classnotfound/home-mon/pcb/home_checker/hom_mon_pcb.pdf

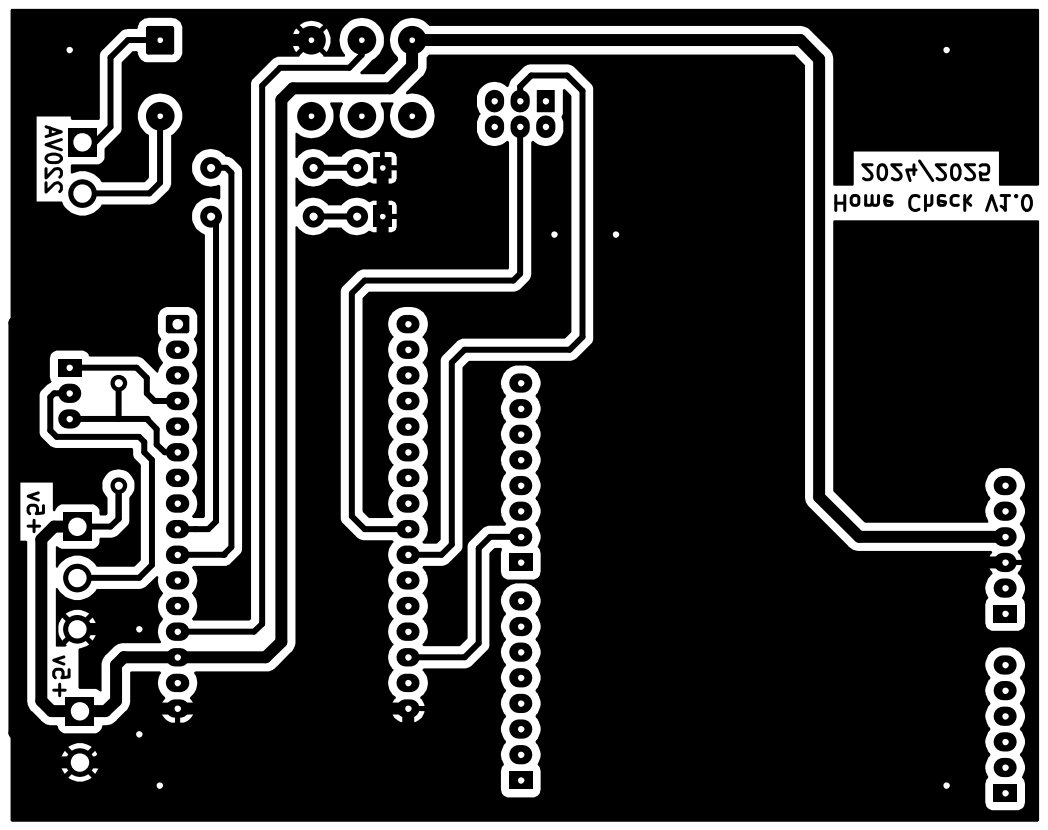
[picture p1: page 1]
