classnotfound/home-mon/pcb/home_checker/home_mon.kicad_pcb

## KiCad design pcb/home_checker/home_mon.kicad_pcb (2025-03-09)

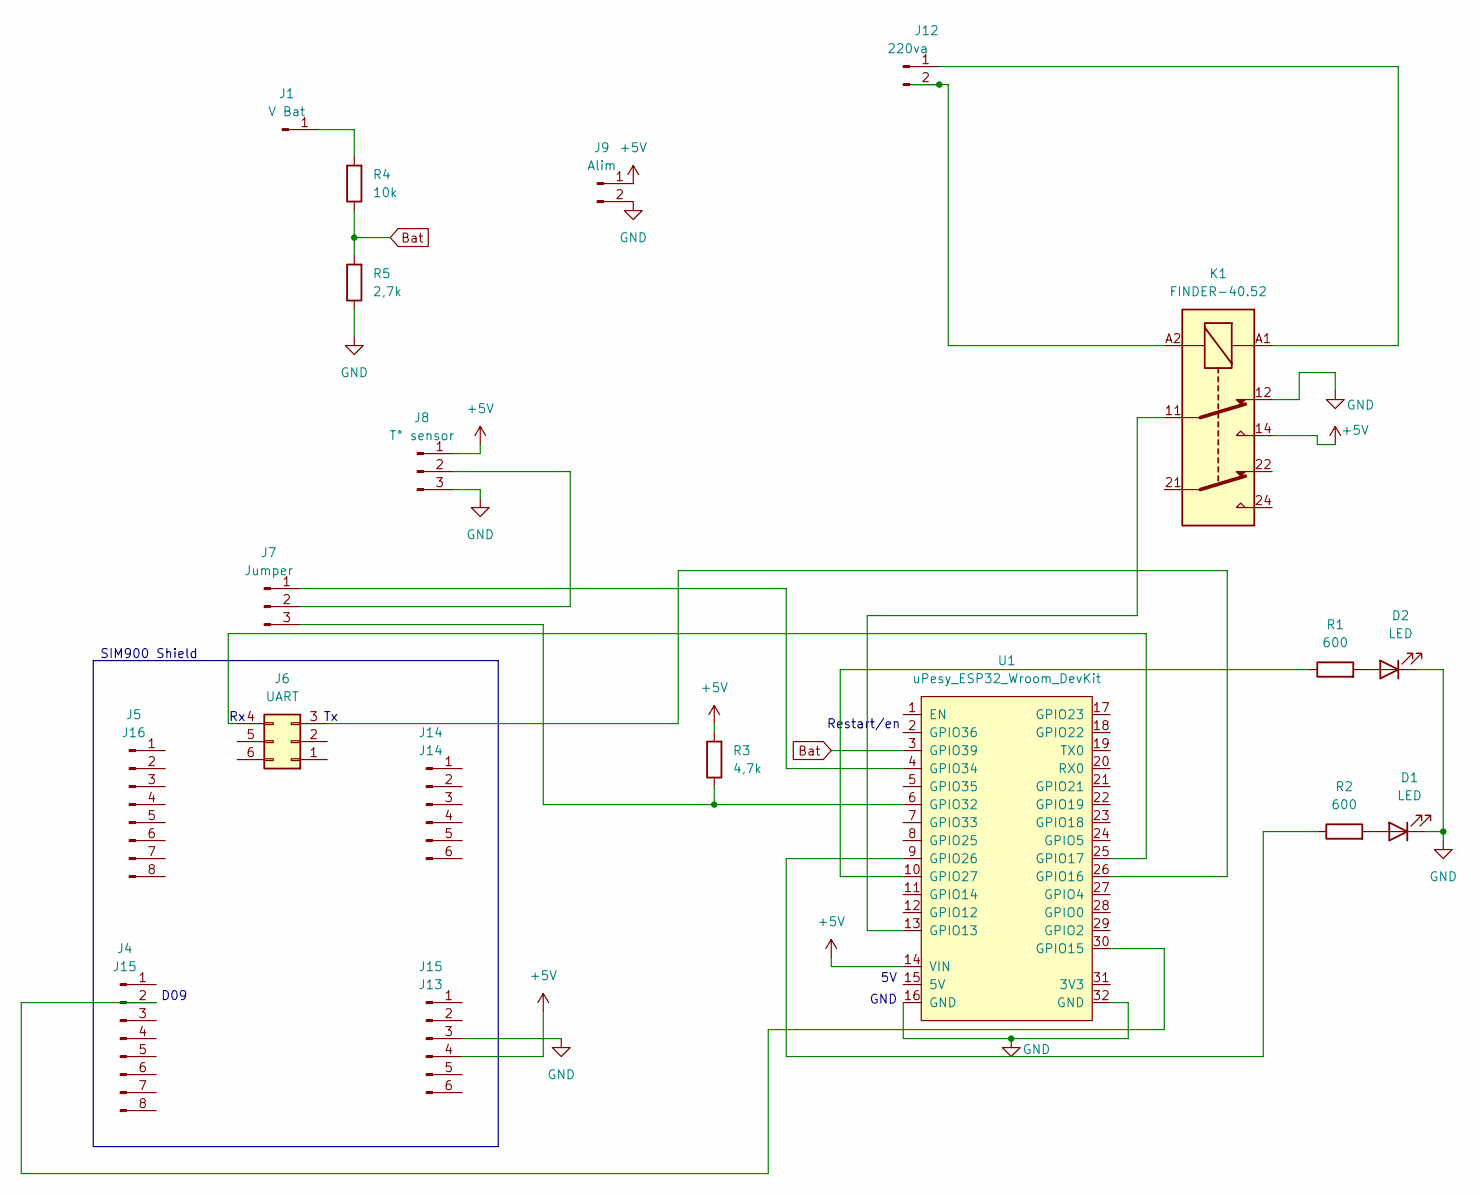
[picture p2: schematic home_mon.kicad_sch]

Parts:
D1, D2: LED; LED_D3.0mm
J1: V Bat; TestPoint_Loop_D1.80mm_Drill1.0mm_Beaded
J4: J15; PinHeader_1x08_P2.54mm_Vertical
J5: J16; PinHeader_1x08_P2.54mm_Vertical
J6: UART; PinHeader_2x03_P2.54mm_Vertical
J7: Jumper; PinHeader_1x03_P2.54mm_Vertical
J8: T° sensor; Samtec_HPM-03-01-x-S_Straight_1x03_Pitch5.08mm
J9: Alim; Samtec_HPM-02-01-x-S_Straight_1x02_Pitch5.08mm
J12: 220va; Samtec_HPM-02-01-x-S_Straight_1x02_Pitch5.08mm
J14: J14; PinHeader_1x06_P2.54mm_Vertical
J15: J13; PinHeader_1x06_P2.54mm_Vertical
K1: FINDER-40.52; Relay_DPDT_Finder_40.52
R1, R2: 600; R_Axial_DIN0207_L6.3mm_D2.5mm_P10.16mm_Horizontal
R3: 4,7k; R_Axial_DIN0207_L6.3mm_D2.5mm_P10.16mm_Horizontal
R4: 10k; R_Axial_DIN0207_L6.3mm_D2.5mm_P10.16mm_Horizontal
R5: 2,7k; R_Axial_DIN0207_L6.3mm_D2.5mm_P10.16mm_Horizontal
U1: uPesy_ESP32_Wroom_DevKit

Connections:
+5V: J8.1, J9.1, J15.4, K1.14, R3.2, U1.14 (VIN)
Bat: R4.1, R5.2, U1.3 (GPIO39)
GND: D1.1 (K), D2.1 (K), J8.3, J9.2, J15.3, K1.12, R5.1, U1.16 (GND), U1.32 (GND)
unnamed: D1.2 (A), R2.2
unnamed: D2.2 (A), R1.2
unnamed: J1.1, R4.2
unnamed: J4.2, U1.30 (GPIO15)
unnamed: J6.3, U1.26 (GPIO16)
unnamed: J6.4, U1.25 (GPIO17)
unnamed: J7.1, U1.4 (GPIO34)
unnamed: J7.2, J8.2
unnamed: J7.3, R3.1, U1.6 (GPIO32)
unnamed: J12.1, K1.A1
unnamed: J12.2, K1.A2
unnamed: K1.11, U1.13 (GPIO13)
unnamed: R2.1, U1.9 (GPIO26)
unnamed: R1.1, U1.10 (GPIO27)

Notes on the sheet:
Restart/en
D09
SIM900 Shield
GND

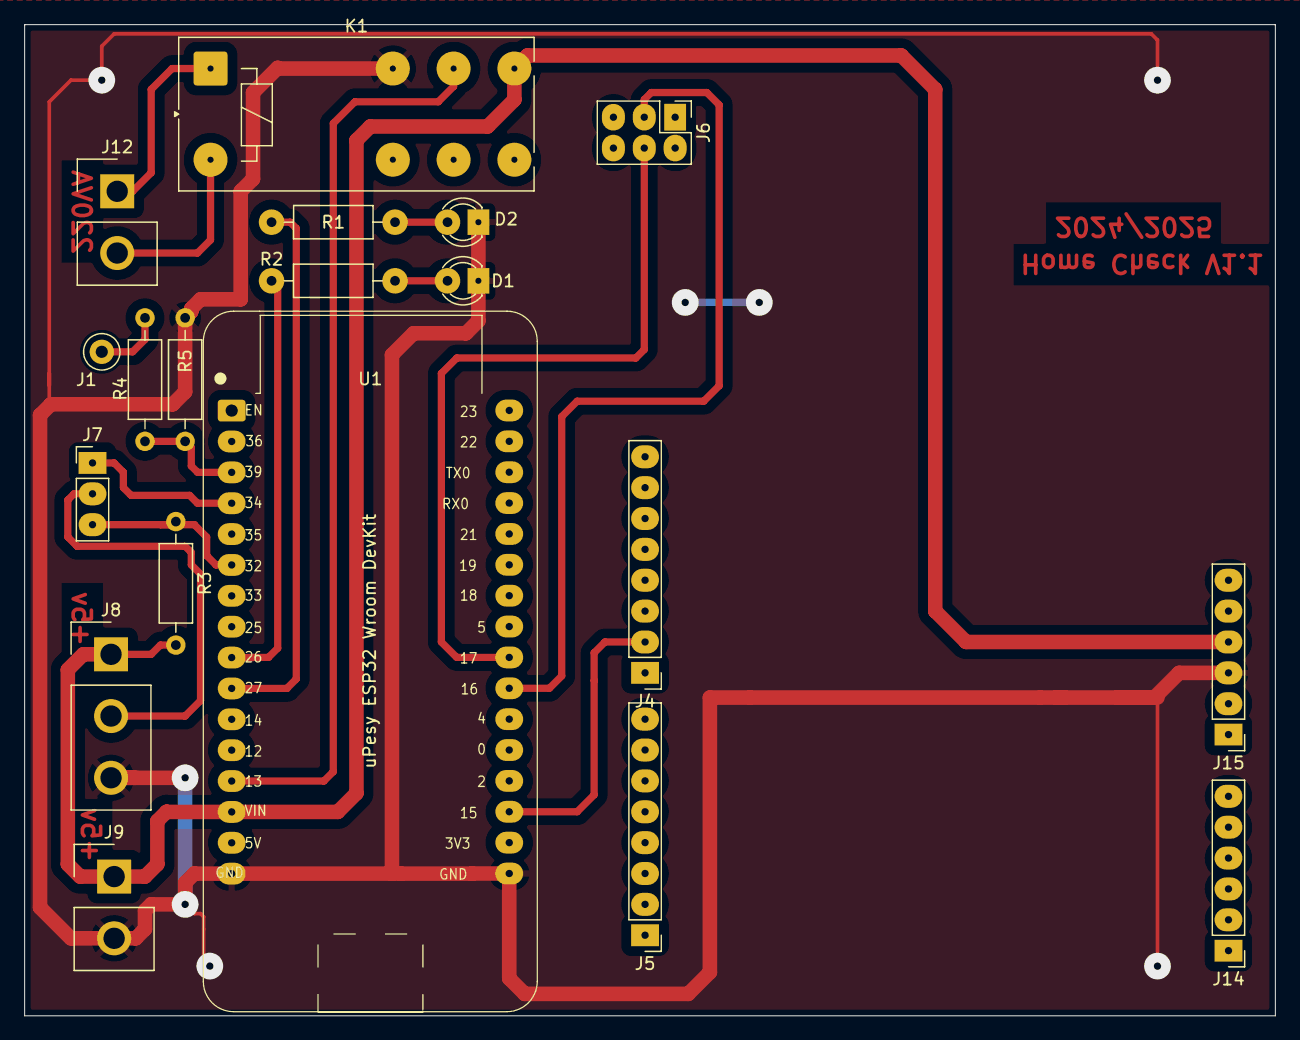
[picture p3: board home_mon.kicad_pcb from above]

Board: 2 copper layers, 102.9 x 81.6 mm, 19 parts (0 on the bottom side), 17 nets.
