classnotfound/home-mon/pcb/home_checker/temp_sensor/temp_sensor.kicad_pcb

## KiCad design pcb/home_checker/temp_sensor/temp_sensor.kicad_pcb (2025-03-01)

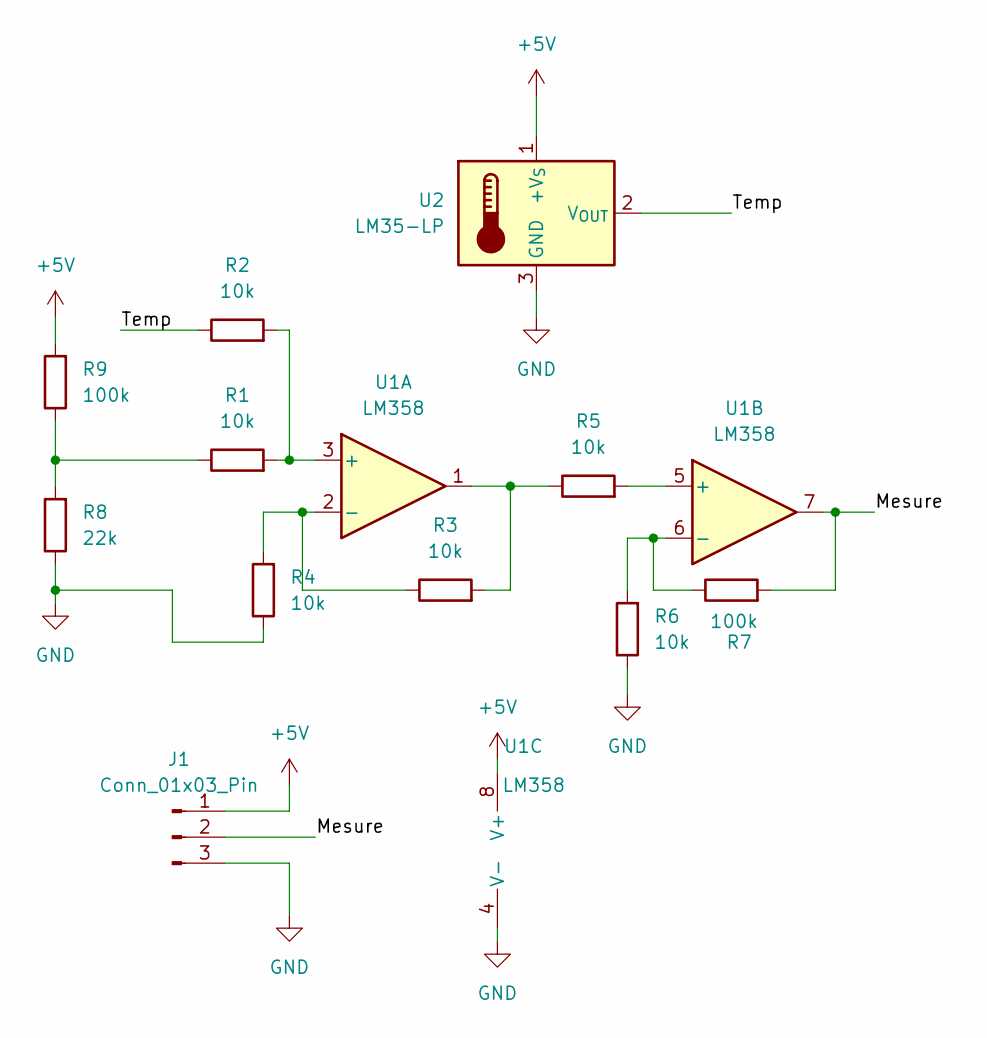
[picture p4: schematic temp_sensor.kicad_sch]

Parts:
J1: Conn_01x03_Pin; Samtec_HPM-03-01-x-S_Straight_1x03_Pitch5.08mm
R1, R2, R3, R4, R5, R6: 10k; R_Axial_DIN0207_L6.3mm_D2.5mm_P10.16mm_Horizontal
R7, R9: 100k; R_Axial_DIN0207_L6.3mm_D2.5mm_P10.16mm_Horizontal
R8: 22k; R_Axial_DIN0207_L6.3mm_D2.5mm_P10.16mm_Horizontal
U1: LM358; CERDIP-8_W7.62mm_SideBrazed_LongPads
U2: LM35-LP; TO-92_Inline

Connections:
+5V: J1.1, R9.2, U1.8 (V+), U2.1 (+V_{S})
/Mesure: J1.2, R7.2, U1.7
/Temp: R2.1, U2.2 (V_{OUT})
GND: J1.3, R4.1, R6.1, R8.1, U1.4 (V-), U2.3 (GND)
unnamed: R1.1, R8.2, R9.1
unnamed: R3.2, R5.1, U1.1
unnamed: R1.2, R2.2, U1.3 (+)
unnamed: R3.1, R4.2, U1.2 (-)
unnamed: R5.2, U1.5 (+)
unnamed: R6.2, R7.1, U1.6 (-)

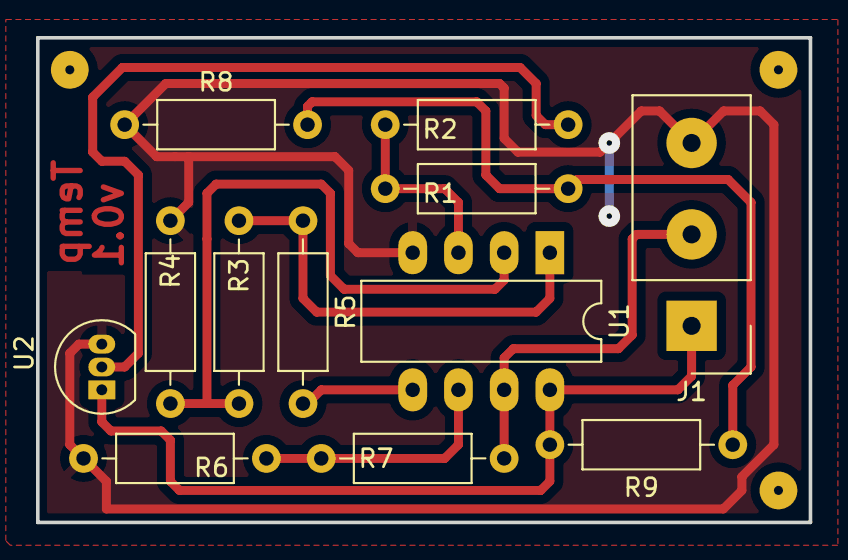
[picture p5: board temp_sensor.kicad_pcb from above]

Board: 2 copper layers, 42.9 x 26.9 mm, 12 parts (0 on the bottom side), 10 nets.
