classnotfound/home-mon/(commit log)

2025-03-01 First version of the Home Monitor
    [home_mon.kicad_pcb, home_mon.kicad_sch, temp_sensor.kicad_pcb, temp_sensor.kicad_sch]
2025-03-03 feat: Make implementation multiusers fix competition issues using semaphores make temperature alerting using averaged temperature instead of direct reading
    [check_main.ino, power_monitor.cpp, sim900.cpp, sim900.h, temp_sensor.cpp, temp_sensor.h]
2025-03-06 feat: Monitor the battery voltage
    [home_mon.kicad_pcb, home_mon.kicad_sch]
2025-03-09 fix: Make the sending of sending operational again (canary exception) Make the ADC more reliable
    [home_mon.kicad_pcb, home_mon.kicad_sch]
2025-03-11 feat: Finalize battery voltage measurement add a reboot command
    [battery_monitor.cpp, battery_monitor.h, sim900.cpp]
